Zchander/adria/kicad/templates/Adria_cpu_template/meta/board.png

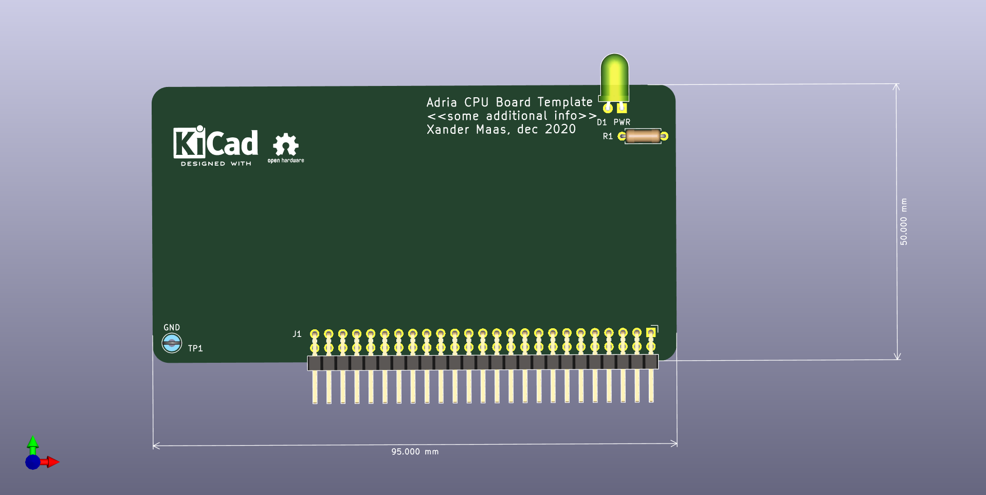
kicad/templates/Adria_cpu_template/meta/board.png
