Zchander/adria/kicad/templates/Adria_backplane_template/meta/board.png

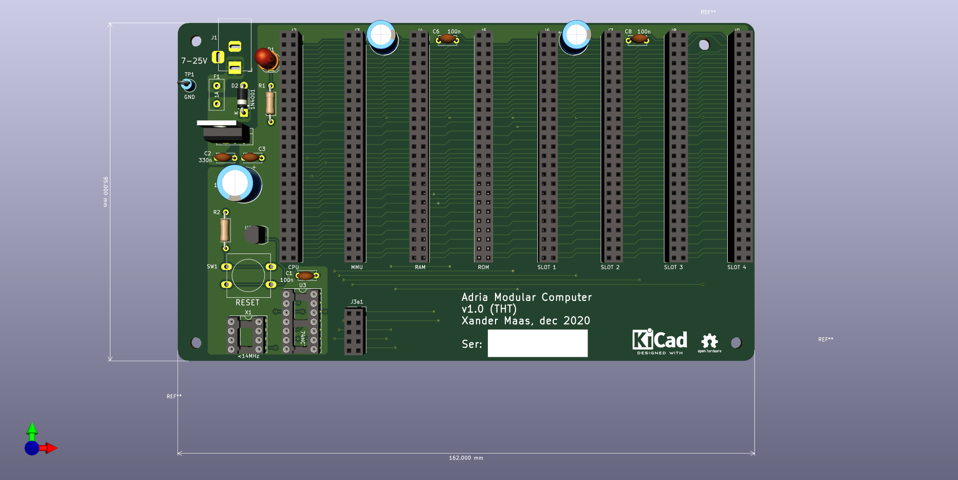
kicad/templates/Adria_backplane_template/meta/board.png
