Zchander/adria/README.md

# adria
Adria is a 8/16-bit computer based on Lilith

# Where to find more info
You can find more info (and track the project) at [hackaday.io](https://hackaday.io/project/177856-adria-a-65c816-based-computer)
