Zchander/adria/kicad/templates/Adria_mmu_template/meta/board.png

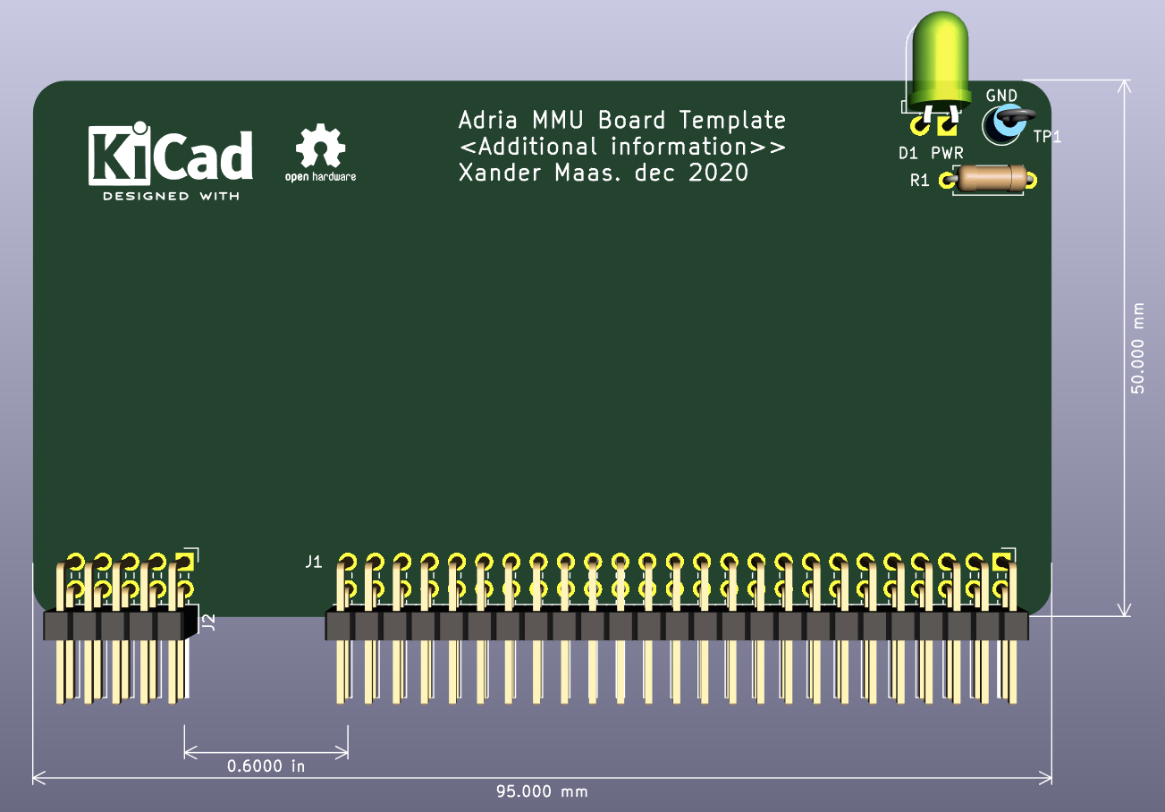
kicad/templates/Adria_mmu_template/meta/board.png
