Zchander/adria/kicad/templates/Adria_slot_template/meta/board.png

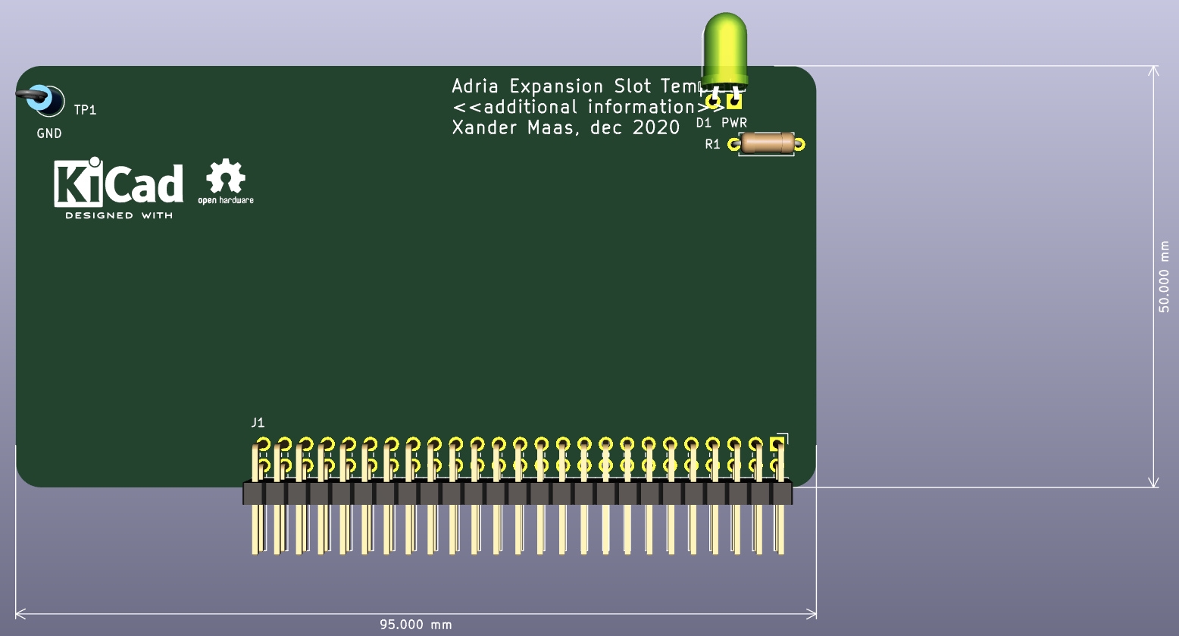
kicad/templates/Adria_slot_template/meta/board.png
