Zchander/adria/kicad/CPU_65816_DIP40_V1.0/CPU_65816_DIP40_V1.0.sch

## KiCad design kicad/CPU_65816_DIP40_V1.0/CPU_65816_DIP40_V1.0.sch (2021-02-24)

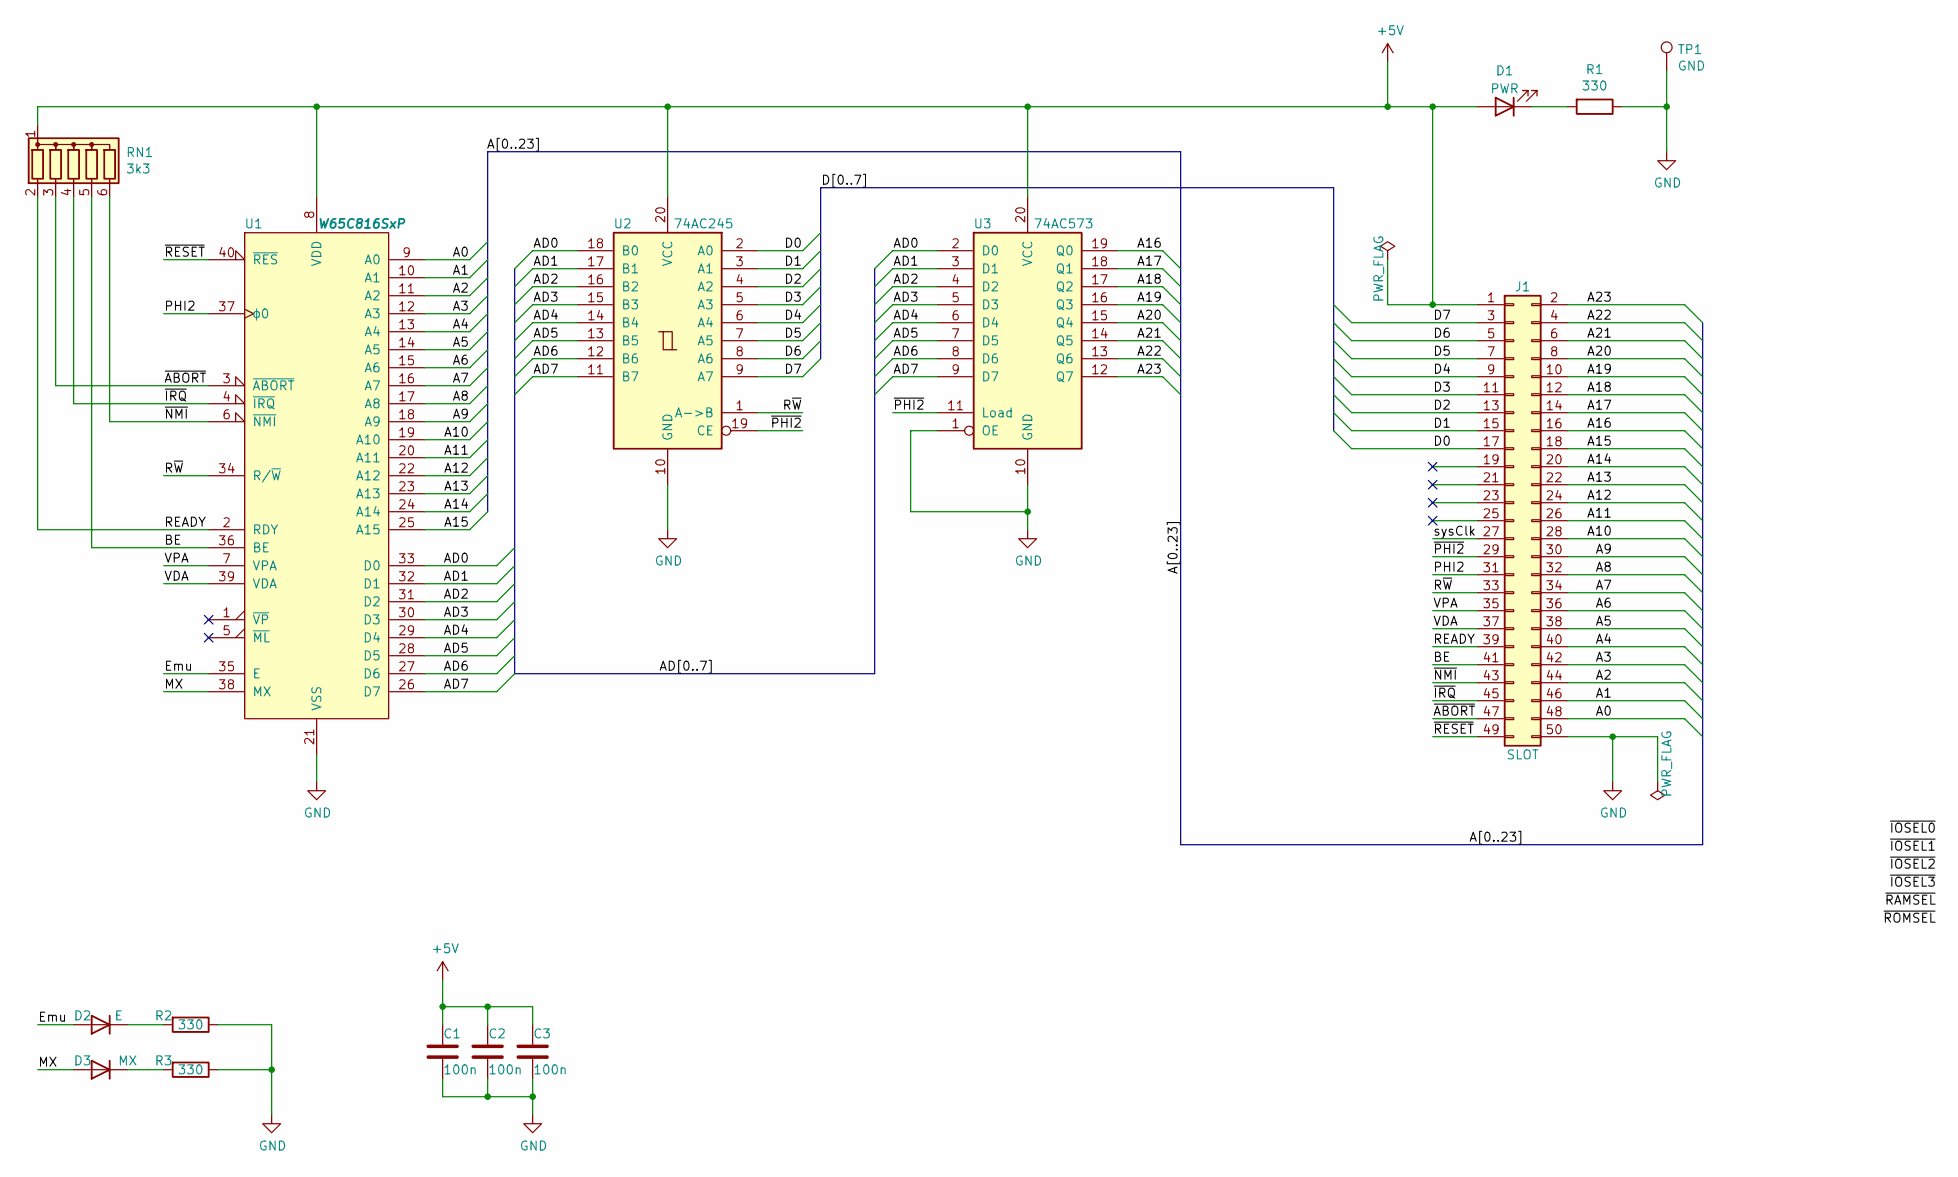
[picture p5: schematic CPU_65816_DIP40_V1.0.sch]

Parts:
C1, C2, C3: 100n; C_Disc_D5.0mm_W2.5mm_P5.00mm
D1: PWR; LED_D5.0mm_Horizontal_O1.27mm_Z3.0mm
D2: E; LED_D5.0mm_Horizontal_O1.27mm_Z3.0mm
D3: MX; LED_D5.0mm_Horizontal_O1.27mm_Z3.0mm
J1: SLOT; PinHeader_2x25_P2.54mm_Horizontal
R1, R2, R3: 330; R_Axial_DIN0207_L6.3mm_D2.5mm_P7.62mm_Horizontal
RN1: 3k3; R_Array_SIP6
TP1: GND; TestPoint_Loop_D3.50mm_Drill1.4mm_Beaded
U1: W65C816SxP; DIP-40_W15.24mm_Socket_LongPads
U2: 74AC245; DIP-20_W7.62mm_Socket_LongPads
U3: 74AC573; DIP-20_W7.62mm_Socket_LongPads

Connections:
+5V: C1.1, C2.1, C3.1, D1.2 (A), J1.1, RN1.1 (common), U1.8 (VDD), U2.20 (VCC), U3.20 (VCC)
A0: J1.48, U1.9 (A0)
A1: J1.46, U1.10 (A1)
A2: J1.44, U1.11 (A2)
A3: J1.42, U1.12 (A3)
A4: J1.40, U1.13 (A4)
A5: J1.38, U1.14 (A5)
A6: J1.36, U1.15 (A6)
A7: J1.34, U1.16 (A7)
A8: J1.32, U1.17 (A8)
A9: J1.30, U1.18 (A9)
A10: J1.28, U1.19 (A10)
A11: J1.26, U1.20 (A11)
A12: J1.24, U1.22 (A12)
A13: J1.22, U1.23 (A13)
A14: J1.20, U1.24 (A14)
A15: J1.18, U1.25 (A15)
A16: J1.16, U3.19 (Q0)
A17: J1.14, U3.18 (Q1)
A18: J1.12, U3.17 (Q2)
A19: J1.10, U3.16 (Q3)
A20: J1.8, U3.15 (Q4)
A21: J1.6, U3.14 (Q5)
A22: J1.4, U3.13 (Q6)
A23: J1.2, U3.12 (Q7)
AD0: U1.33 (D0), U2.18 (B0), U3.2 (D0)
AD1: U1.32 (D1), U2.17 (B1), U3.3 (D1)
AD2: U1.31 (D2), U2.16 (B2), U3.4 (D2)
AD3: U1.30 (D3), U2.15 (B3), U3.5 (D3)
AD4: U1.29 (D4), U2.14 (B4), U3.6 (D4)
AD5: U1.28 (D5), U2.13 (B5), U3.7 (D5)
AD6: U1.27 (D6), U2.12 (B6), U3.8 (D6)
AD7: U1.26 (D7), U2.11 (B7), U3.9 (D7)
BE: J1.41, RN1.5 (R4), U1.36 (BE)
D0: J1.17, U2.2 (A0)
D1: J1.15, U2.3 (A1)
D2: J1.13, U2.4 (A2)
D3: J1.11, U2.5 (A3)
D4: J1.9, U2.6 (A4)
D5: J1.7, U2.7 (A5)
D6: J1.5, U2.8 (A6)
D7: J1.3, U2.9 (A7)
Emu: D2.2 (A), U1.35 (E)
GND: C1.2, C2.2, C3.2, J1.50, R1.1, R2.1, R3.1, TP1.1, U1.21 (VSS), U2.10 (GND), U3.1 (OE), U3.10 (GND)
MX: D3.2 (A), U1.38 (MX)
unnamed: D1.1 (K), R1.2
unnamed: D2.1 (K), R2.2
unnamed: D3.1 (K), R3.2
PHI2: J1.31, U1.37 (ϕ0)
READY: J1.39, RN1.2 (R1), U1.2 (RDY)
R~W: J1.33, U1.34 (R/~W), U2.1 (A->B)
VDA: J1.37, U1.39 (VDA)
VPA: J1.35, U1.7 (VPA)
sysClk: J1.27
~ABORT: J1.47, RN1.3 (R2), U1.3 (~ABORT)
~IRQ: J1.45, RN1.4 (R3), U1.4 (~IRQ)
~NMI: J1.43, RN1.6 (R5), U1.6 (~NMI)
~PHI2: J1.29, U2.19 (CE), U3.11 (Load)
~RESET: J1.49, U1.40 (~RES)
