Zchander/adria/kicad/MMU_2x22v10_v1.0/MMU_2x22v10_v1.0.sch

## KiCad design kicad/MMU_2x22v10_v1.0/MMU_2x22v10_v1.0.sch (2021-02-24)

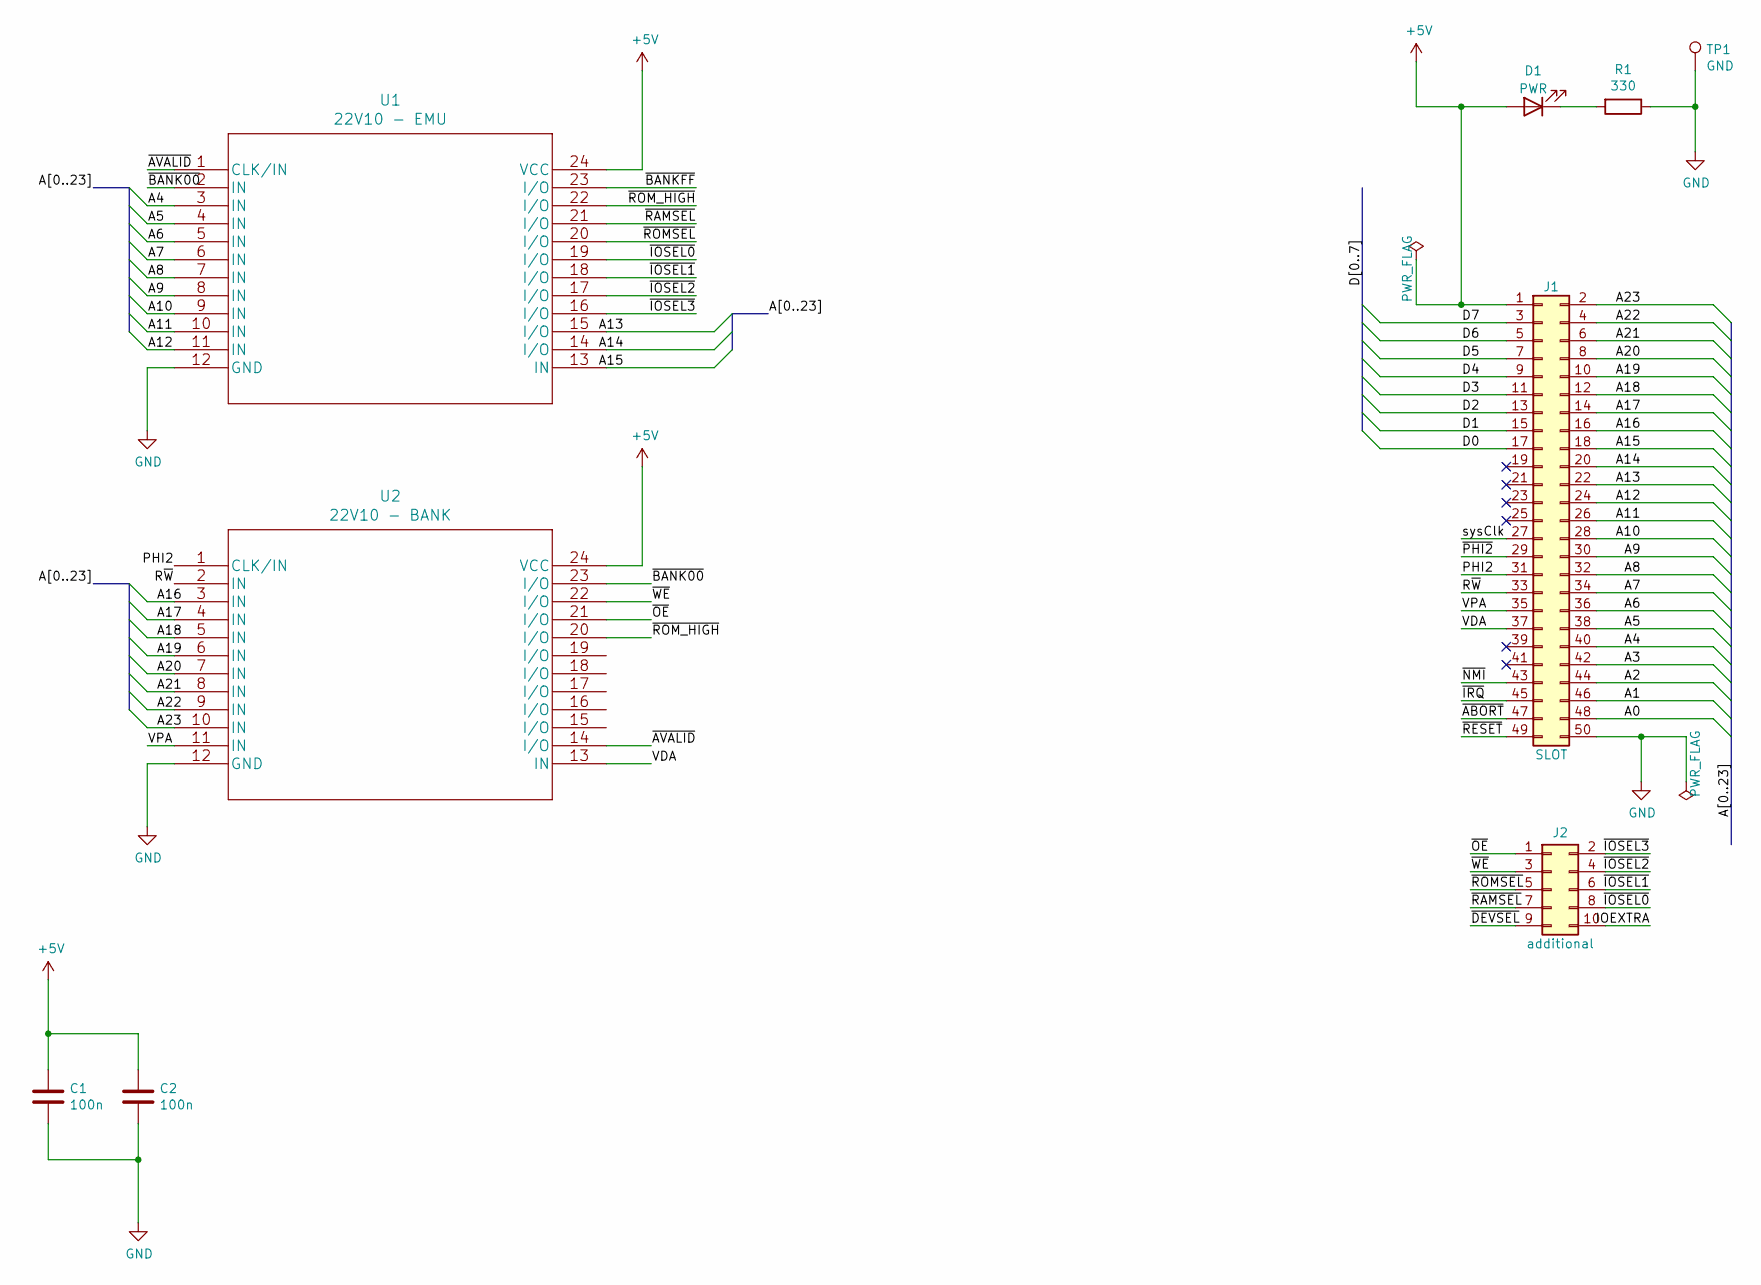
[picture p6: schematic MMU_2x22v10_v1.0.sch]

Parts:
C1, C2: 100n; C_Disc_D7.0mm_W2.5mm_P5.00mm
D1: PWR; LED_D5.0mm_Horizontal_O1.27mm_Z3.0mm
J1: SLOT; PinHeader_2x25_P2.54mm_Horizontal
J2: additional; PinHeader_2x05_P2.54mm_Horizontal
R1: 330; R_Axial_DIN0207_L6.3mm_D2.5mm_P7.62mm_Horizontal
TP1: GND; TestPoint_Loop_D3.50mm_Drill1.4mm_Beaded
U1: 22V10 - EMU; DIP-24_W7.62mm_LongPads
U2: 22V10 - BANK; DIP-24_W7.62mm_LongPads

Connections:
+5V: C1.1, C2.1, D1.2 (A), J1.1, U1.24 (VCC), U2.24 (VCC)
A0: J1.48
A1: J1.46
A2: J1.44
A3: J1.42
A4: J1.40, U1.3 (IN)
A5: J1.38, U1.4 (IN)
A6: J1.36, U1.5 (IN)
A7: J1.34, U1.6 (IN)
A8: J1.32, U1.7 (IN)
A9: J1.30, U1.8 (IN)
A10: J1.28, U1.9 (IN)
A11: J1.26, U1.10 (IN)
A12: J1.24, U1.11 (IN)
A13: J1.22, U1.15 (I/O)
A14: J1.20, U1.14 (I/O)
A15: J1.18, U1.13 (IN)
A16: J1.16, U2.3 (IN)
A17: J1.14, U2.4 (IN)
A18: J1.12, U2.5 (IN)
A19: J1.10, U2.6 (IN)
A20: J1.8, U2.7 (IN)
A21: J1.6, U2.8 (IN)
A22: J1.4, U2.9 (IN)
A23: J1.2, U2.10 (IN)
D0: J1.17
D1: J1.15
D2: J1.13
D3: J1.11
D4: J1.9
D5: J1.7
D6: J1.5
D7: J1.3
GND: C1.2, C2.2, J1.50, R1.1, TP1.1, U1.12 (GND), U2.12 (GND)
IOEXTRA: J2.10
unnamed: D1.1 (K), R1.2
PHI2: J1.31, U2.1 (CLK/IN)
R~W: J1.33, U2.2 (IN)
VDA: J1.37, U2.13 (IN)
VPA: J1.35, U2.11 (IN)
sysClk: J1.27
~ABORT: J1.47
~AVALID: U1.1 (CLK/IN), U2.14 (I/O)
~BANK00: U1.2 (IN), U2.23 (I/O)
~BANKFF: U1.23 (I/O)
~DEVSEL: J2.9
~IOSEL0: J2.8, U1.19 (I/O)
~IOSEL1: J2.6, U1.18 (I/O)
~IOSEL2: J2.4, U1.17 (I/O)
~IOSEL3: J2.2, U1.16 (I/O)
~IRQ: J1.45
~NMI: J1.43
~OE: J2.1, U2.21 (I/O)
~PHI2: J1.29
~RAMSEL: J2.7, U1.21 (I/O)
~RESET: J1.49
~ROMSEL: J2.5, U1.20 (I/O)
~ROM_HIGH: U1.22 (I/O), U2.20 (I/O)
~WE: J2.3, U2.22 (I/O)
