Zchander/adria/kicad/ROM_27_28_DIP/ROM_27_28_DIP.sch

## KiCad design kicad/ROM_27_28_DIP/ROM_27_28_DIP.sch (2021-02-24)

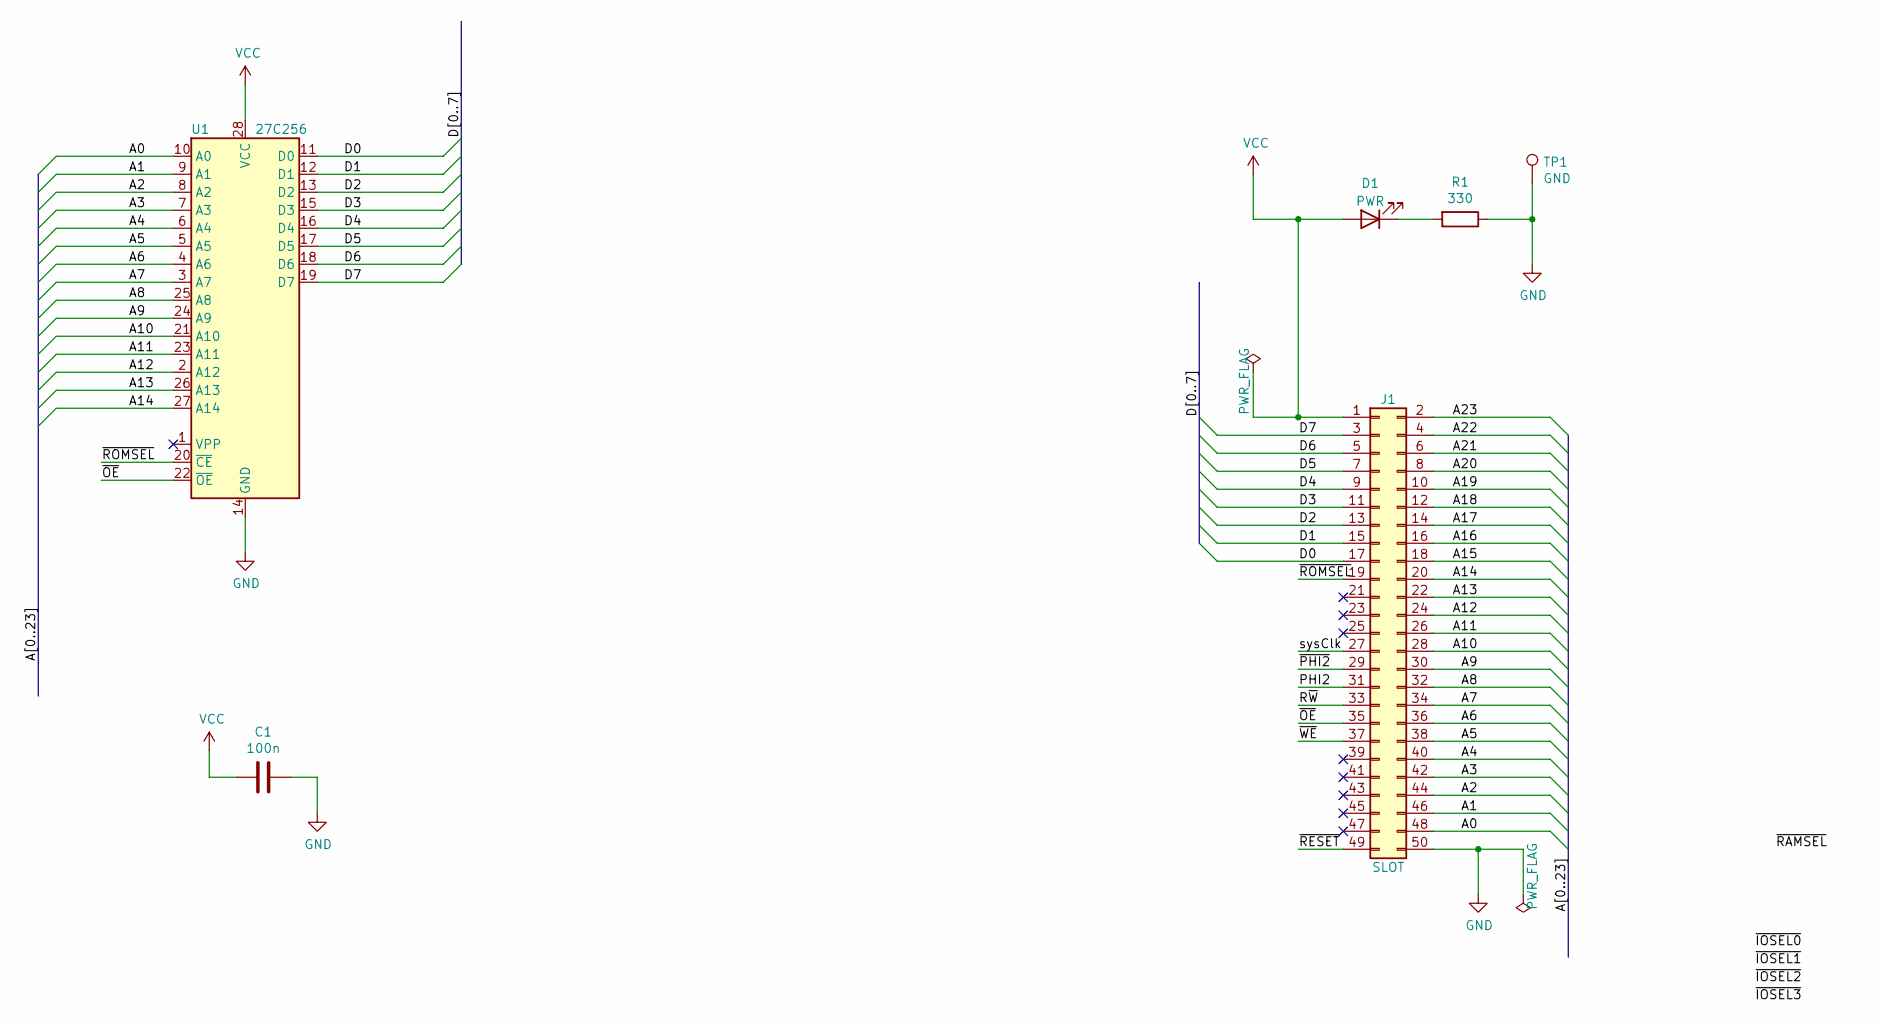
[picture p8: schematic ROM_27_28_DIP.sch]

Parts:
C1: 100n; C_Disc_D5.0mm_W2.5mm_P5.00mm
D1: PWR; LED_D5.0mm_Horizontal_O1.27mm_Z3.0mm
J1: SLOT; PinHeader_2x25_P2.54mm_Horizontal
R1: 330; R_Axial_DIN0207_L6.3mm_D2.5mm_P7.62mm_Horizontal
TP1: GND; TestPoint_Loop_D3.50mm_Drill1.4mm_Beaded
U1: 27C256; DIP-28_W15.24mm_LongPads

Connections:
A0: J1.48, U1.10 (A0)
A1: J1.46, U1.9 (A1)
A2: J1.44, U1.8 (A2)
A3: J1.42, U1.7 (A3)
A4: J1.40, U1.6 (A4)
A5: J1.38, U1.5 (A5)
A6: J1.36, U1.4 (A6)
A7: J1.34, U1.3 (A7)
A8: J1.32, U1.25 (A8)
A9: J1.30, U1.24 (A9)
A10: J1.28, U1.21 (A10)
A11: J1.26, U1.23 (A11)
A12: J1.24, U1.2 (A12)
A13: J1.22, U1.26 (A13)
A14: J1.20, U1.27 (A14)
A15: J1.18
A16: J1.16
A17: J1.14
A18: J1.12
A19: J1.10
A20: J1.8
A21: J1.6
A22: J1.4
A23: J1.2
D0: J1.17, U1.11 (D0)
D1: J1.15, U1.12 (D1)
D2: J1.13, U1.13 (D2)
D3: J1.11, U1.15 (D3)
D4: J1.9, U1.16 (D4)
D5: J1.7, U1.17 (D5)
D6: J1.5, U1.18 (D6)
D7: J1.3, U1.19 (D7)
GND: C1.1, J1.50, R1.1, TP1.1, U1.14 (GND)
unnamed: D1.1 (K), R1.2
PHI2: J1.31
R~W: J1.33
VCC: C1.2, D1.2 (A), J1.1, U1.28 (VCC)
sysClk: J1.27
~OE: J1.35, U1.22 (~OE)
~PHI2: J1.29
~RESET: J1.49
~ROMSEL: J1.19, U1.20 (~CE)
~WE: J1.37
