Zchander/adria/kicad/UART_6551_DIP_v1.0/UART_6551_DIP_v1.0.sch

## KiCad design kicad/UART_6551_DIP_v1.0/UART_6551_DIP_v1.0.sch (2021-02-24)

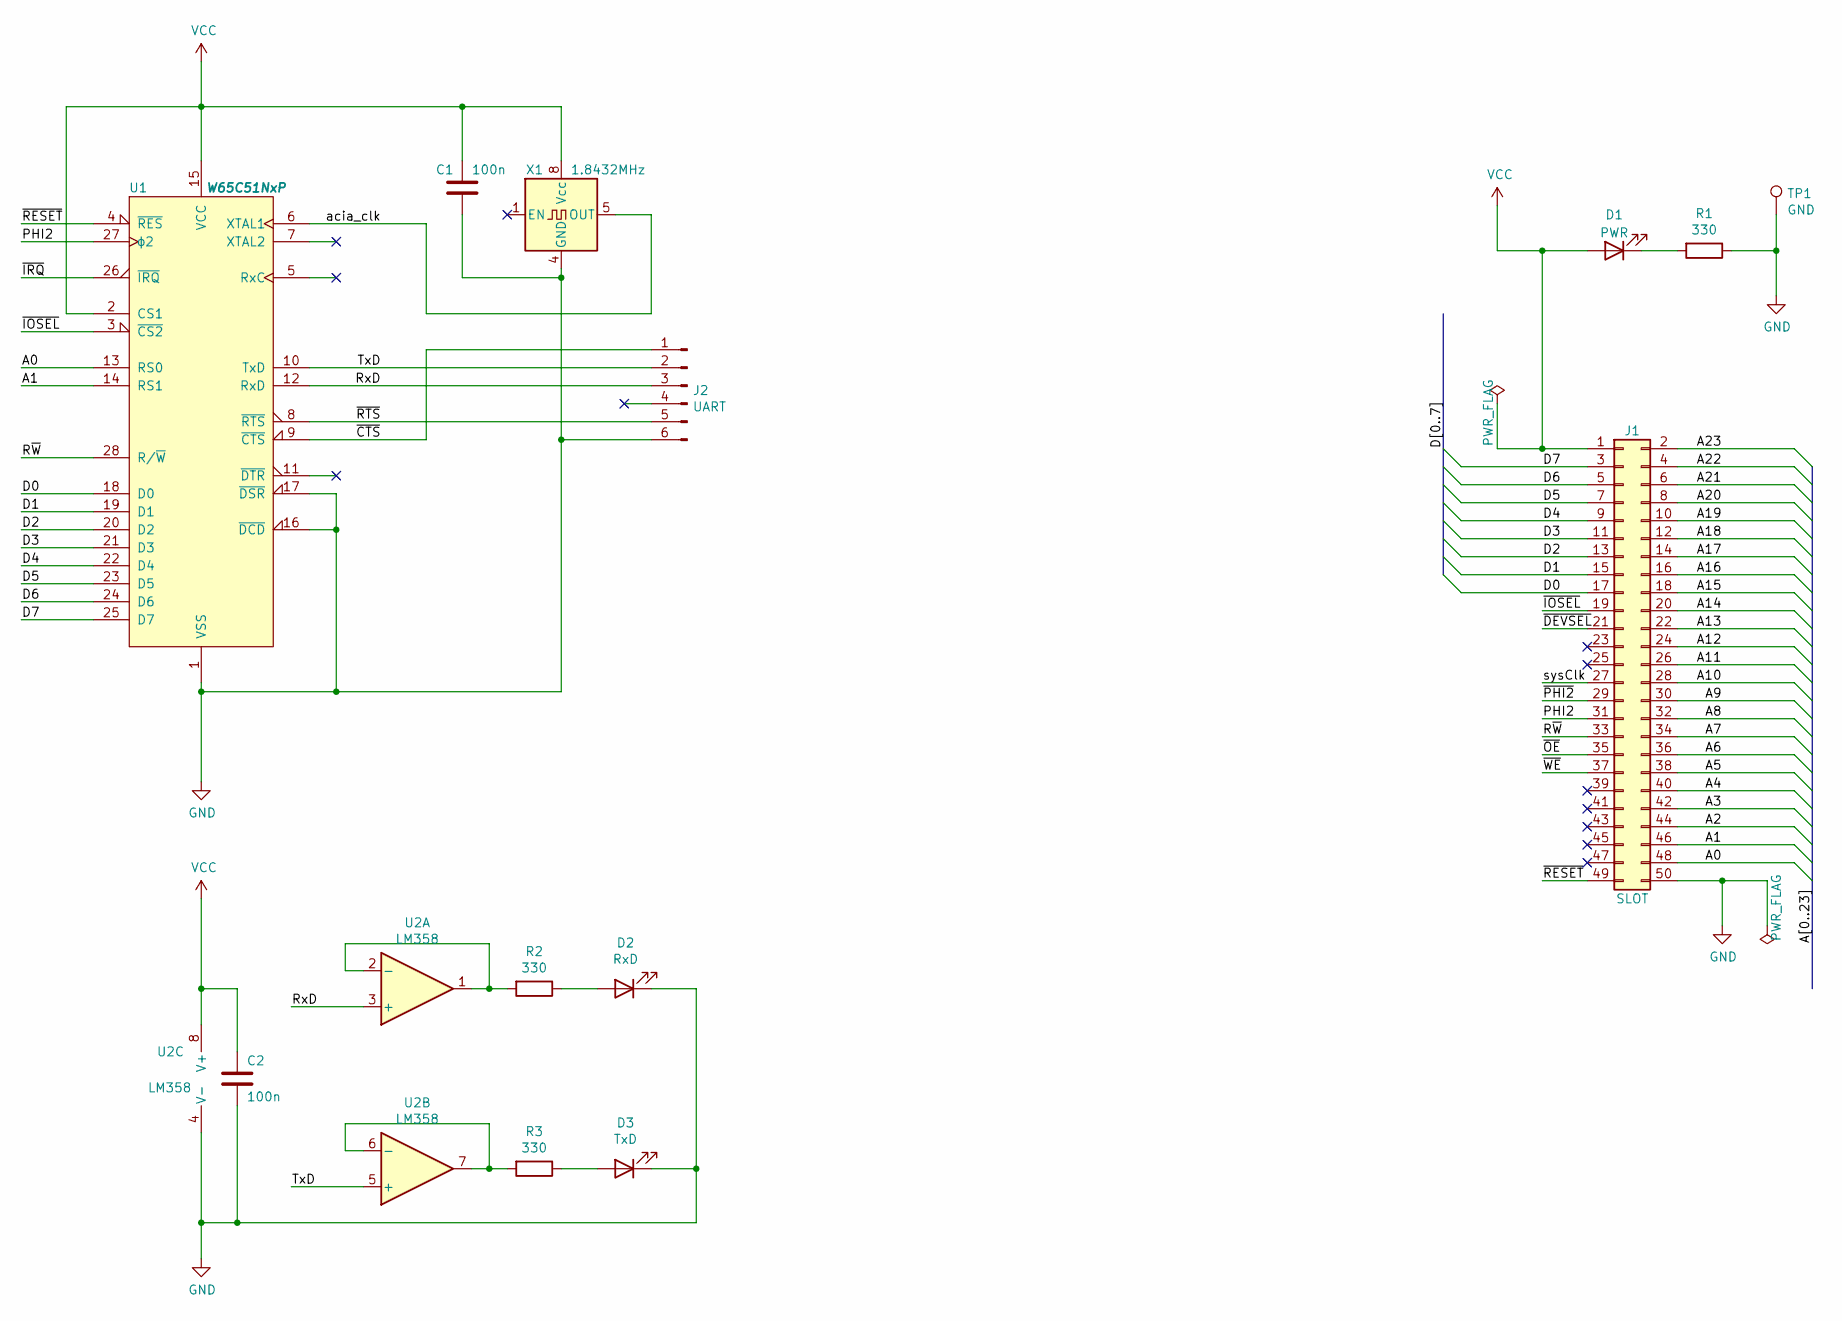
[picture p9: schematic UART_6551_DIP_v1.0.sch]

Parts:
C1, C2: 100n; C_Disc_D5.0mm_W2.5mm_P5.00mm
D1: PWR; LED_D5.0mm_Horizontal_O1.27mm_Z3.0mm
D2: RxD; LED_D5.0mm_Horizontal_O1.27mm_Z3.0mm
D3: TxD; LED_D5.0mm_Horizontal_O1.27mm_Z3.0mm
J1: SLOT; PinHeader_2x25_P2.54mm_Horizontal
J2: UART; PinHeader_1x06_P2.54mm_Horizontal
R1, R2, R3: 330; R_Axial_DIN0207_L6.3mm_D2.5mm_P7.62mm_Horizontal
TP1: GND; TestPoint_Loop_D3.50mm_Drill1.4mm_Beaded
U1: W65C51NxP; DIP-28_W15.24mm_Socket_LongPads
U2: LM358; DIP-8_W7.62mm_Socket_LongPads
X1: 1.8432MHz; DIP-8_W7.62mm_Socket_LongPads

Connections:
A0: J1.48, U1.13 (RS0)
A1: J1.46, U1.14 (RS1)
A2: J1.44
A3: J1.42
A4: J1.40
A5: J1.38
A6: J1.36
A7: J1.34
A8: J1.32
A9: J1.30
A10: J1.28
A11: J1.26
A12: J1.24
A13: J1.22
A14: J1.20
A15: J1.18
A16: J1.16
A17: J1.14
A18: J1.12
A19: J1.10
A20: J1.8
A21: J1.6
A22: J1.4
A23: J1.2
D0: J1.17, U1.18 (D0)
D1: J1.15, U1.19 (D1)
D2: J1.13, U1.20 (D2)
D3: J1.11, U1.21 (D3)
D4: J1.9, U1.22 (D4)
D5: J1.7, U1.23 (D5)
D6: J1.5, U1.24 (D6)
D7: J1.3, U1.25 (D7)
GND: C1.2, C2.2, D2.1 (K), D3.1 (K), J1.50, J2.6, R1.1, TP1.1, U1.1 (VSS), U1.16 (~DCD), U1.17 (~DSR), U2.4 (V-), X1.4 (GND)
unnamed: D1.1 (K), R1.2
unnamed: D2.2 (A), R2.1
unnamed: D3.2 (A), R3.1
unnamed: R2.2, U2.1, U2.2 (-)
unnamed: R3.2, U2.6 (-), U2.7
PHI2: J1.31, U1.27 (ϕ2)
RxD: J2.3, U1.12 (RxD), U2.3 (+)
R~W: J1.33, U1.28 (R/~W)
TxD: J2.2, U1.10 (TxD), U2.5 (+)
VCC: C1.1, C2.1, D1.2 (A), J1.1, U1.2 (CS1), U1.15 (VCC), U2.8 (V+), X1.8 (Vcc)
acia_clk: U1.6 (XTAL1), X1.5 (OUT)
sysClk: J1.27
~CTS: J2.1, U1.9 (~CTS)
~DEVSEL: J1.21
~IOSEL: J1.19, U1.3 (~CS2)
~IRQ: U1.26 (~IRQ)
~OE: J1.35
~PHI2: J1.29
~RESET: J1.49, U1.4 (~RES)
~RTS: J2.5, U1.8 (~RTS)
~WE: J1.37
