Zchander/adria/kicad/UART_SC28L92_PLCC/UART_SC28L92_PLCC.sch

## KiCad design kicad/UART_SC28L92_PLCC/UART_SC28L92_PLCC.sch (2021-02-24)

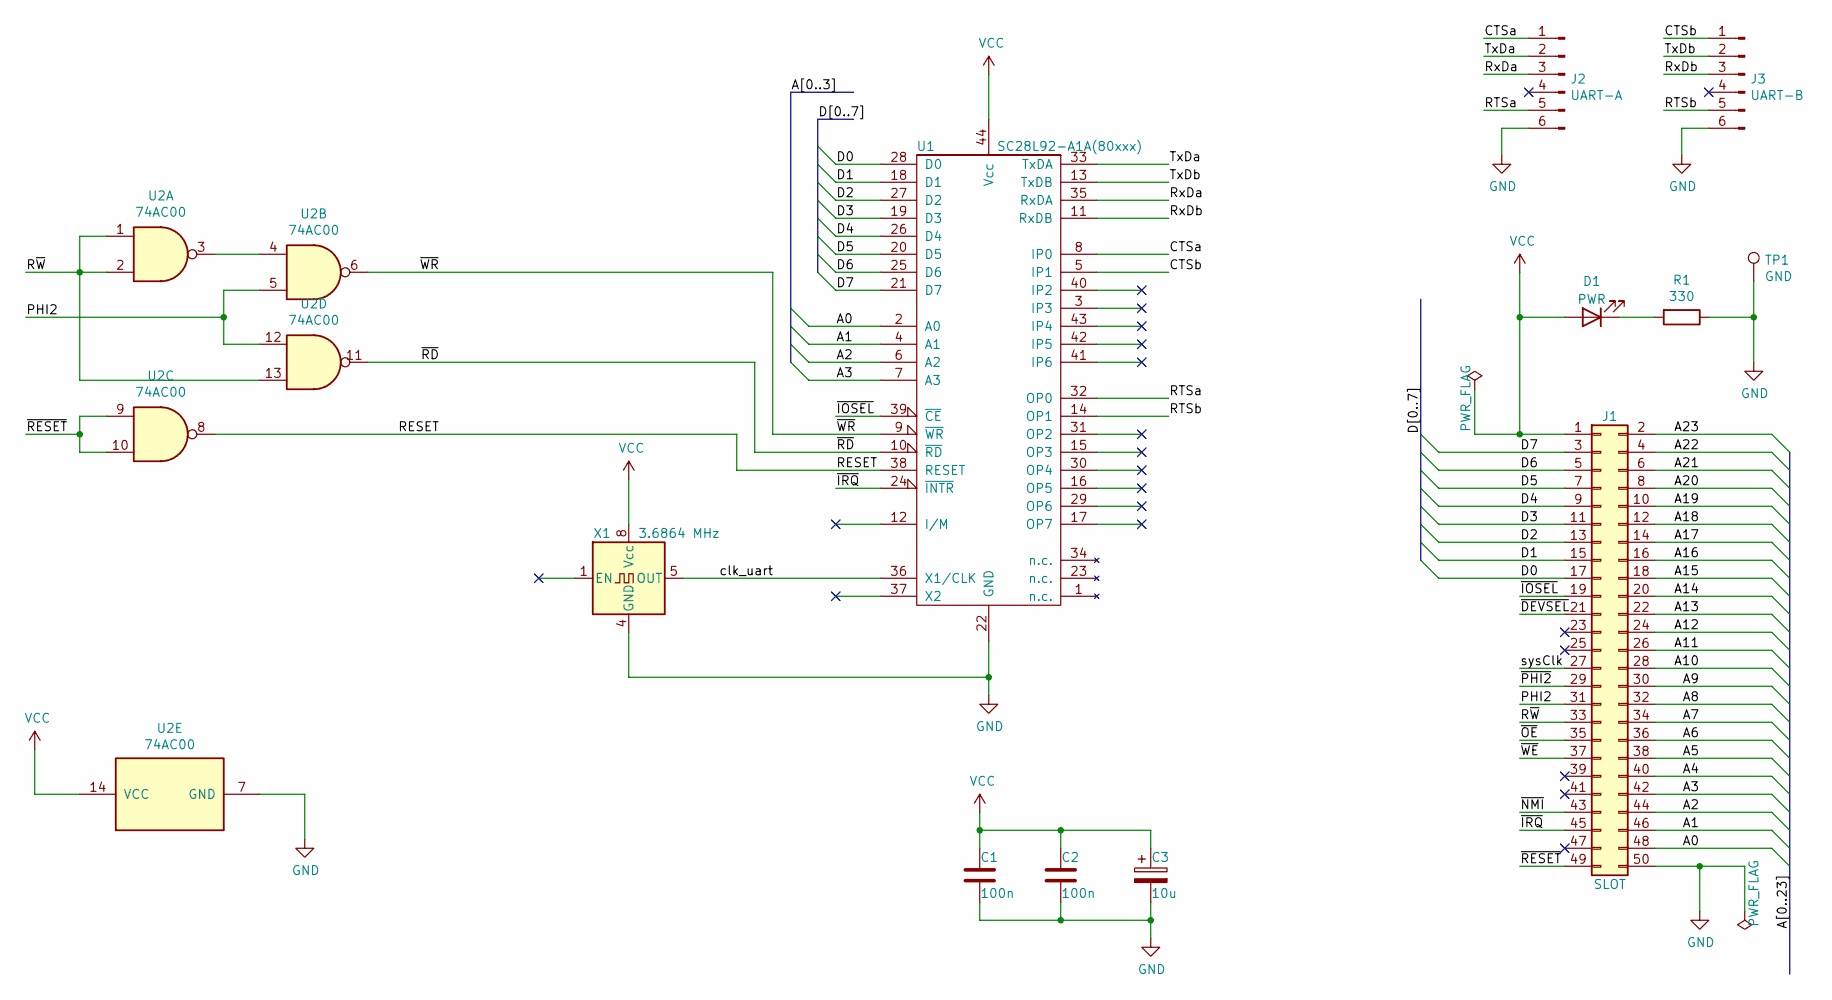
[picture p10: schematic UART_SC28L92_PLCC.sch]

Parts:
C1, C2: 100n; C_Disc_D5.0mm_W2.5mm_P5.00mm
C3: 10u; CP_Radial_D8.0mm_P5.00mm
D1: PWR; LED_D5.0mm_Horizontal_O1.27mm_Z3.0mm
J1: SLOT; PinHeader_2x25_P2.54mm_Horizontal
J2: UART-A; PinHeader_1x06_P2.54mm_Horizontal
J3: UART-B; PinHeader_1x06_P2.54mm_Horizontal
R1: 330; R_Axial_DIN0207_L6.3mm_D2.5mm_P7.62mm_Horizontal
TP1: GND; TestPoint_Loop_D3.50mm_Drill1.4mm_Beaded
U1: SC28L92-A1A(80xxx); PLCC-44_THT-Socket
U2: 74AC00; DIP-14_W7.62mm_Socket_LongPads
X1: 3.6864 MHz; DIP-8_W7.62mm_LongPads

Connections:
A0: J1.48, U1.2 (A0)
A1: J1.46, U1.4 (A1)
A2: J1.44, U1.6 (A2)
A3: J1.42, U1.7 (A3)
A4: J1.40
A5: J1.38
A6: J1.36
A7: J1.34
A8: J1.32
A9: J1.30
A10: J1.28
A11: J1.26
A12: J1.24
A13: J1.22
A14: J1.20
A15: J1.18
A16: J1.16
A17: J1.14
A18: J1.12
A19: J1.10
A20: J1.8
A21: J1.6
A22: J1.4
A23: J1.2
CTSa: J2.1, U1.8 (IP0)
CTSb: J3.1, U1.5 (IP1)
D0: J1.17, U1.28 (D0)
D1: J1.15, U1.18 (D1)
D2: J1.13, U1.27 (D2)
D3: J1.11, U1.19 (D3)
D4: J1.9, U1.26 (D4)
D5: J1.7, U1.20 (D5)
D6: J1.5, U1.25 (D6)
D7: J1.3, U1.21 (D7)
GND: C1.2, C2.2, C3.2, J1.50, J2.6, J3.6, R1.1, TP1.1, U1.22 (GND), U2.7 (GND), X1.4 (GND)
unnamed: D1.1 (K), R1.2
unnamed: U2.3, U2.4
PHI2: J1.31, U2.5, U2.12
RESET: U1.38 (RESET), U2.8
RTSa: J2.5, U1.32 (OP0)
RTSb: J3.5, U1.14 (OP1)
RxDa: J2.3, U1.35 (RxDA)
RxDb: J3.3, U1.11 (RxDB)
R~W: J1.33, U2.1, U2.2, U2.13
TxDa: J2.2, U1.33 (TxDA)
TxDb: J3.2, U1.13 (TxDB)
VCC: C1.1, C2.1, C3.1, D1.2 (A), J1.1, U1.44 (Vcc), U2.14 (VCC), X1.8 (Vcc)
clk_uart: U1.36 (X1/CLK), X1.5 (OUT)
sysClk: J1.27
~DEVSEL: J1.21
~IOSEL: J1.19, U1.39 (~CE)
~IRQ: J1.45, U1.24 (~INTR)
~NMI: J1.43
~OE: J1.35
~PHI2: J1.29
~RD: U1.10 (~RD), U2.11
~RESET: J1.49, U2.9, U2.10
~WE: J1.37
~WR: U1.9 (~WR), U2.6
