Zchander/adria/kicad/backplane_v2.0/backplane_v2.0.sch

## KiCad design kicad/backplane_v2.0/backplane_v2.0.sch (2021-02-24)

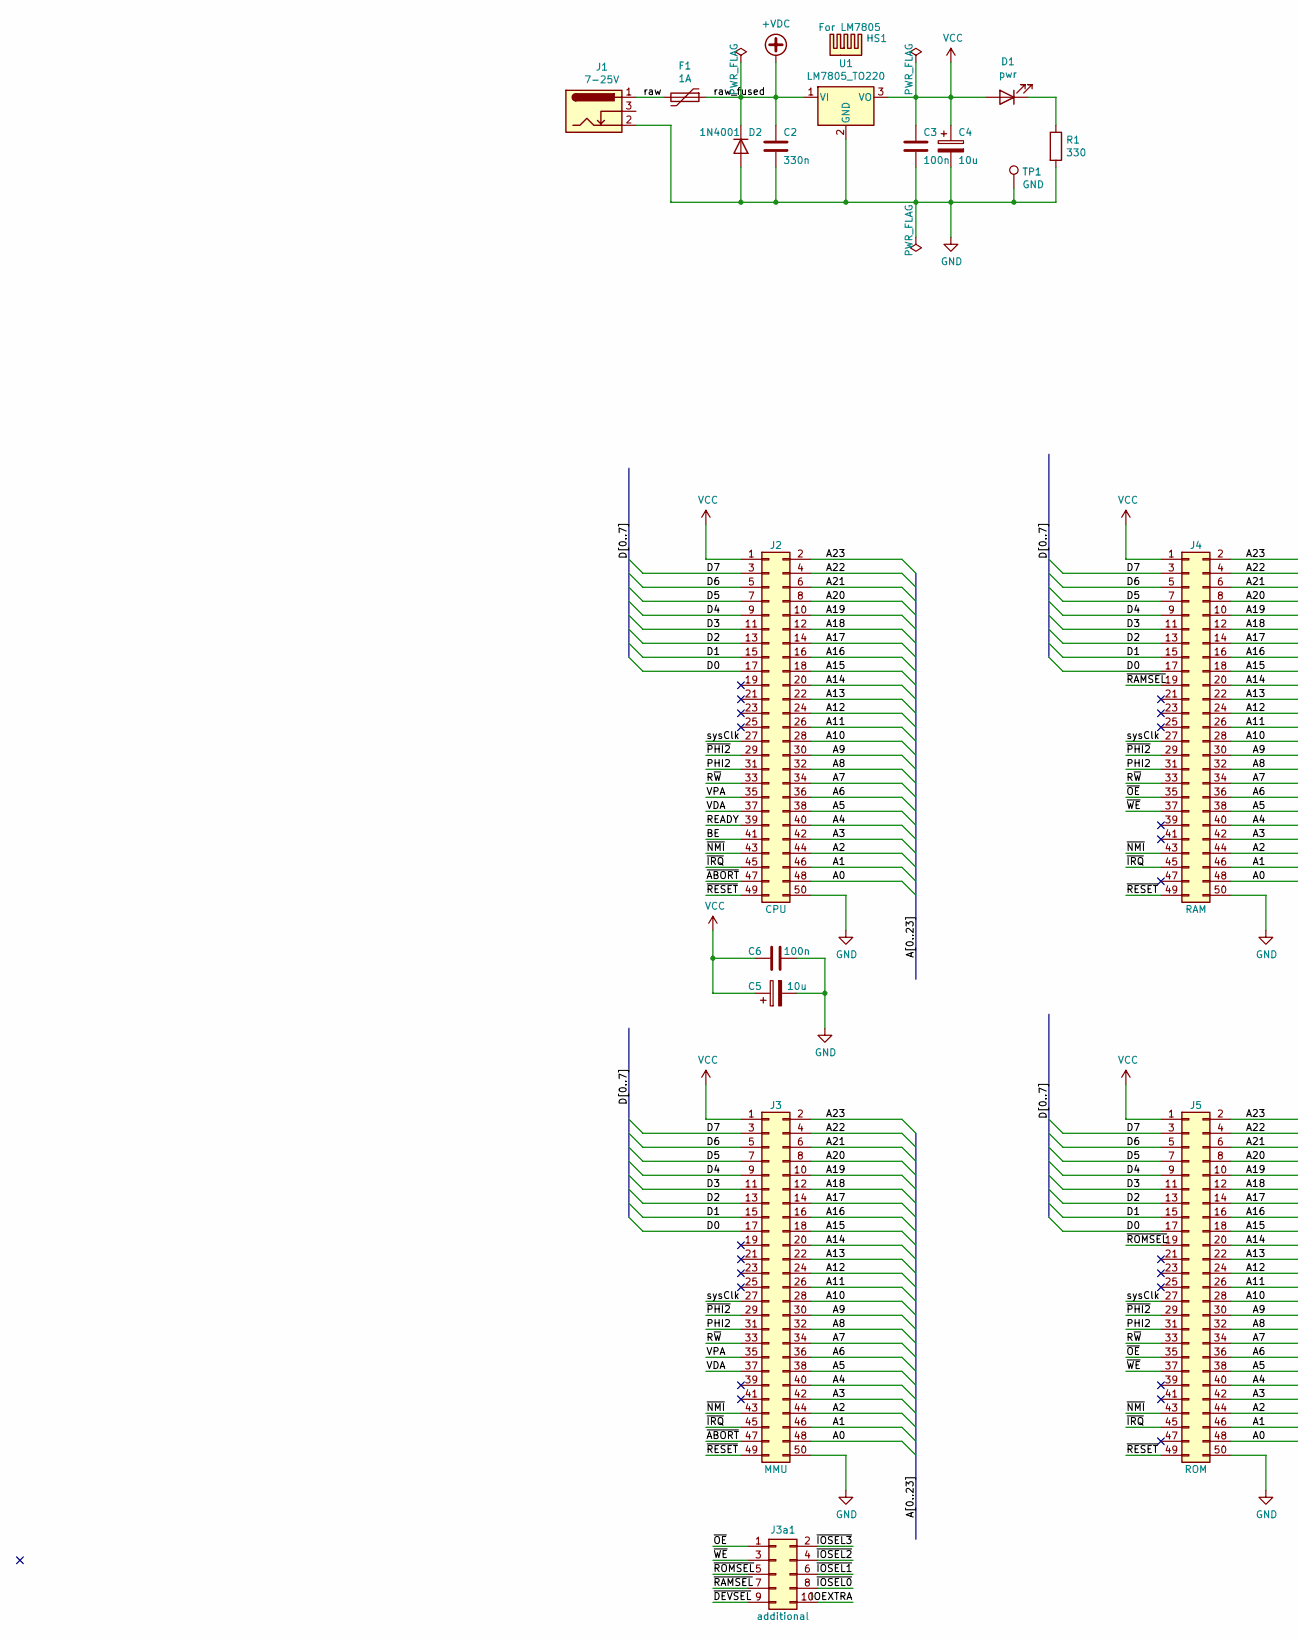
[picture p11: schematic backplane_v2.0.sch, part in row 1, column 1]

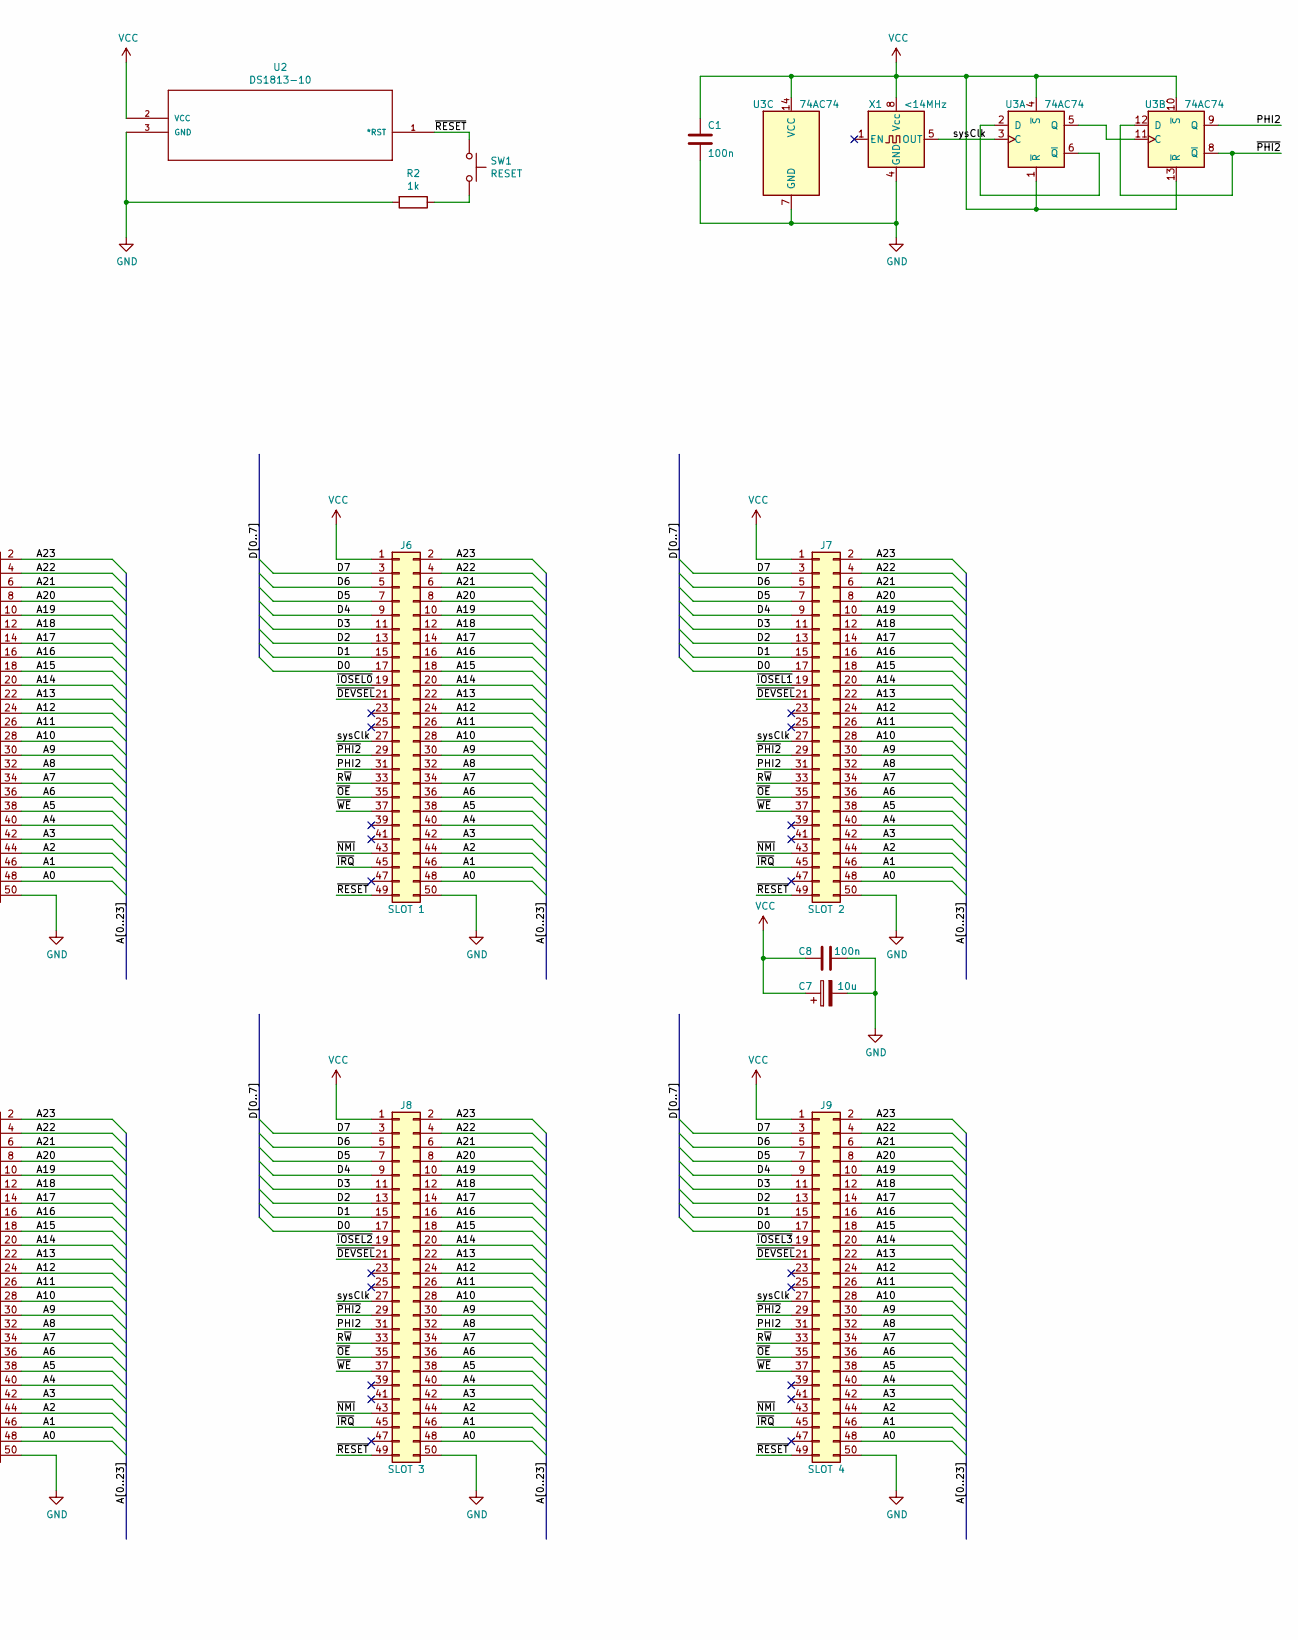
[picture p12: schematic backplane_v2.0.sch, part in row 1, column 2]

Parts:
C1: 100n; C_Disc_D5.0mm_W2.5mm_P5.00mm
C2: 330n; C_Disc_D5.0mm_W2.5mm_P5.00mm; mpn C322C334K5R5TA
C3, C6, C8: 100n; C_Disc_D5.0mm_W2.5mm_P5.00mm; mpn C322C104K5R5TA7301
C4, C5, C7: 10u; CP_Radial_D8.0mm_P2.50mm; mpn ESK106M016AC3AA
D1: pwr; LED_D5.0mm; mpn LTL2R3KRD-EM
D2: 1N4001; D_DO-41_SOD81_P7.62mm_Horizontal; mpn 1N4001G
F1: 1A; Fuse_Littelfuse_395Series; mpn MF-R075
HS1: For LM7805
J1: 7-25V; BarrelJack_Horizontal
J2: CPU; PinSocket_2x25_P2.54mm_Vertical
J3: MMU; PinSocket_2x25_P2.54mm_Vertical; mpn 929975-01-25-RK
J3a1: additional; PinSocket_2x05_P2.54mm_Vertical
J4: RAM; PinSocket_2x25_P2.54mm_Vertical
J5: ROM; PinSocket_2x25_P2.54mm_Vertical
J6: SLOT 1; PinSocket_2x25_P2.54mm_Vertical
J7: SLOT 2; PinSocket_2x25_P2.54mm_Vertical
J8: SLOT 3; PinSocket_2x25_P2.54mm_Vertical
J9: SLOT 4; PinSocket_2x25_P2.54mm_Vertical
R1: 330; R_Axial_DIN0207_L6.3mm_D2.5mm_P10.16mm_Horizontal; mpn CCF07330RJKE36
R2: 1k; R_Axial_DIN0207_L6.3mm_D2.5mm_P10.16mm_Horizontal; mpn CCF071K00GKE36
SW1: RESET; SW_PUSH-12mm; mpn FSM101
TP1: GND; TestPoint_Loop_D3.50mm_Drill1.4mm_Beaded
U1: LM7805_TO220; TO-220-3_Vertical; mpn LM7805CT/NOPB
U2: DS1813-10; TO-92L_Inline_Wide; mpn ds1813-10+
U3: 74AC74; DIP-14_W7.62mm_Socket_LongPads
X1: <14MHz; DIP-8_W7.62mm_Socket_LongPads; mpn MXO45HS-3C-4M0000;110-87-308-41-001101

Connections:
+VDC: C2.1, D2.1 (K), F1.1, U1.1 (VI)
A0: J2.48, J3.48, J4.48, J5.48, J6.48, J7.48, J8.48, J9.48
A1: J2.46, J3.46, J4.46, J5.46, J6.46, J7.46, J8.46, J9.46
A2: J2.44, J3.44, J4.44, J5.44, J6.44, J7.44, J8.44, J9.44
A3: J2.42, J3.42, J4.42, J5.42, J6.42, J7.42, J8.42, J9.42
A4: J2.40, J3.40, J4.40, J5.40, J6.40, J7.40, J8.40, J9.40
A5: J2.38, J3.38, J4.38, J5.38, J6.38, J7.38, J8.38, J9.38
A6: J2.36, J3.36, J4.36, J5.36, J6.36, J7.36, J8.36, J9.36
A7: J2.34, J3.34, J4.34, J5.34, J6.34, J7.34, J8.34, J9.34
A8: J2.32, J3.32, J4.32, J5.32, J6.32, J7.32, J8.32, J9.32
A9: J2.30, J3.30, J4.30, J5.30, J6.30, J7.30, J8.30, J9.30
A10: J2.28, J3.28, J4.28, J5.28, J6.28, J7.28, J8.28, J9.28
A11: J2.26, J3.26, J4.26, J5.26, J6.26, J7.26, J8.26, J9.26
A12: J2.24, J3.24, J4.24, J5.24, J6.24, J7.24, J8.24, J9.24
A13: J2.22, J3.22, J4.22, J5.22, J6.22, J7.22, J8.22, J9.22
A14: J2.20, J3.20, J4.20, J5.20, J6.20, J7.20, J8.20, J9.20
A15: J2.18, J3.18, J4.18, J5.18, J6.18, J7.18, J8.18, J9.18
A16: J2.16, J3.16, J4.16, J5.16, J6.16, J7.16, J8.16, J9.16
A17: J2.14, J3.14, J4.14, J5.14, J6.14, J7.14, J8.14, J9.14
A18: J2.12, J3.12, J4.12, J5.12, J6.12, J7.12, J8.12, J9.12
A19: J2.10, J3.10, J4.10, J5.10, J6.10, J7.10, J8.10, J9.10
A20: J2.8, J3.8, J4.8, J5.8, J6.8, J7.8, J8.8, J9.8
A21: J2.6, J3.6, J4.6, J5.6, J6.6, J7.6, J8.6, J9.6
A22: J2.4, J3.4, J4.4, J5.4, J6.4, J7.4, J8.4, J9.4
A23: J2.2, J3.2, J4.2, J5.2, J6.2, J7.2, J8.2, J9.2
BE: J2.41
D0: J2.17, J3.17, J4.17, J5.17, J6.17, J7.17, J8.17, J9.17
D1: J2.15, J3.15, J4.15, J5.15, J6.15, J7.15, J8.15, J9.15
D2: J2.13, J3.13, J4.13, J5.13, J6.13, J7.13, J8.13, J9.13
D3: J2.11, J3.11, J4.11, J5.11, J6.11, J7.11, J8.11, J9.11
D4: J2.9, J3.9, J4.9, J5.9, J6.9, J7.9, J8.9, J9.9
D5: J2.7, J3.7, J4.7, J5.7, J6.7, J7.7, J8.7, J9.7
D6: J2.5, J3.5, J4.5, J5.5, J6.5, J7.5, J8.5, J9.5
D7: J2.3, J3.3, J4.3, J5.3, J6.3, J7.3, J8.3, J9.3
GND: C1.2, C2.2, C3.2, C4.2, C5.2, C6.1, C7.2, C8.1, D2.2 (A), J1.2, J2.50, J3.50, J4.50, J5.50, J6.50, J7.50, J8.50, J9.50, R1.2, R2.2, TP1.1, U1.2 (GND), U2.3 (GND), U3.7 (GND), X1.4 (GND)
IOEXTRA: J3a1.10
unnamed: D1.1 (K), R1.1
unnamed: R2.1, SW1.2
unnamed: U3.2 (D), U3.6 (~Q)
unnamed: U3.5 (Q), U3.11 (C)
PHI2: J2.31, J3.31, J4.31, J5.31, J6.31, J7.31, J8.31, J9.31, U3.9 (Q)
READY: J2.39
R~W: J2.33, J3.33, J4.33, J5.33, J6.33, J7.33, J8.33, J9.33
VCC: C1.1, C3.1, C4.1, C5.1, C6.2, C7.1, C8.2, D1.2 (A), J2.1, J3.1, J4.1, J5.1, J6.1, J7.1, J8.1, J9.1, U1.3 (VO), U2.2 (VCC), U3.1 (~R), U3.4 (~S), U3.10 (~S), U3.13 (~R), U3.14 (VCC), X1.8 (Vcc)
VDA: J2.37, J3.37
VPA: J2.35, J3.35
raw: F1.2, J1.1
sysClk: J2.27, J3.27, J4.27, J5.27, J6.27, J7.27, J8.27, J9.27, U3.3 (C), X1.5 (OUT)
~ABORT: J2.47, J3.47
~DEVSEL: J3a1.9, J6.21, J7.21, J8.21, J9.21
~IOSEL0: J3a1.8, J6.19
~IOSEL1: J3a1.6, J7.19
~IOSEL2: J3a1.4, J8.19
~IOSEL3: J3a1.2, J9.19
~IRQ: J2.45, J3.45, J4.45, J5.45, J6.45, J7.45, J8.45, J9.45
~NMI: J2.43, J3.43, J4.43, J5.43, J6.43, J7.43, J8.43, J9.43
~OE: J3a1.1, J4.35, J5.35, J6.35, J7.35, J8.35, J9.35
~PHI2: J2.29, J3.29, J4.29, J5.29, J6.29, J7.29, J8.29, J9.29, U3.8 (~Q), U3.12 (D)
~RAMSEL: J3a1.7, J4.19
~RESET: J2.49, J3.49, J4.49, J5.49, J6.49, J7.49, J8.49, J9.49, SW1.1, U2.1 (*RST)
~ROMSEL: J3a1.5, J5.19
~WE: J3a1.3, J4.37, J5.37, J6.37, J7.37, J8.37, J9.37
