Zchander/adria/(commit log)

2021-02-24 Cleaned project a bit more
    [CPU_65816_DIP40_V1.0-B_Cu.gbr, CPU_65816_DIP40_V1.0-B_Mask.gbr, CPU_65816_DIP40_V1.0-B_SilkS.gbr, CPU_65816_DIP40_V1.0-Edge_Cuts.gbr, CPU_65816_DIP40_V1.0-F_Cu.gbr, CPU_65816_DIP40_V1.0-F_Mask.gbr, CPU_65816_DIP40_V1.0-F_SilkS.gbr, CPU_65816_DIP40_V1.0-NPTH.drl]
2021-03-08 Adapted ehbasic v2.22p5 for Adria (RAM only) Corrected two little bugs in Supermon816
    [NXP28L92.asm, ehbasic_2.22p5.asm, hexintel.asm, isr.asm, main.asm, nx_global.asm]
2021-03-18 - Reordered memory map - stack for Supermon816 moved to top of RAM, 8kByte? - reference for hwstack moved to global.asm - moved UART buffers down in memory
